Toolauth/wing-reader/breakoutconnect.kicad_sch

## KiCad design breakoutconnect.kicad_sch (2026-04-14)

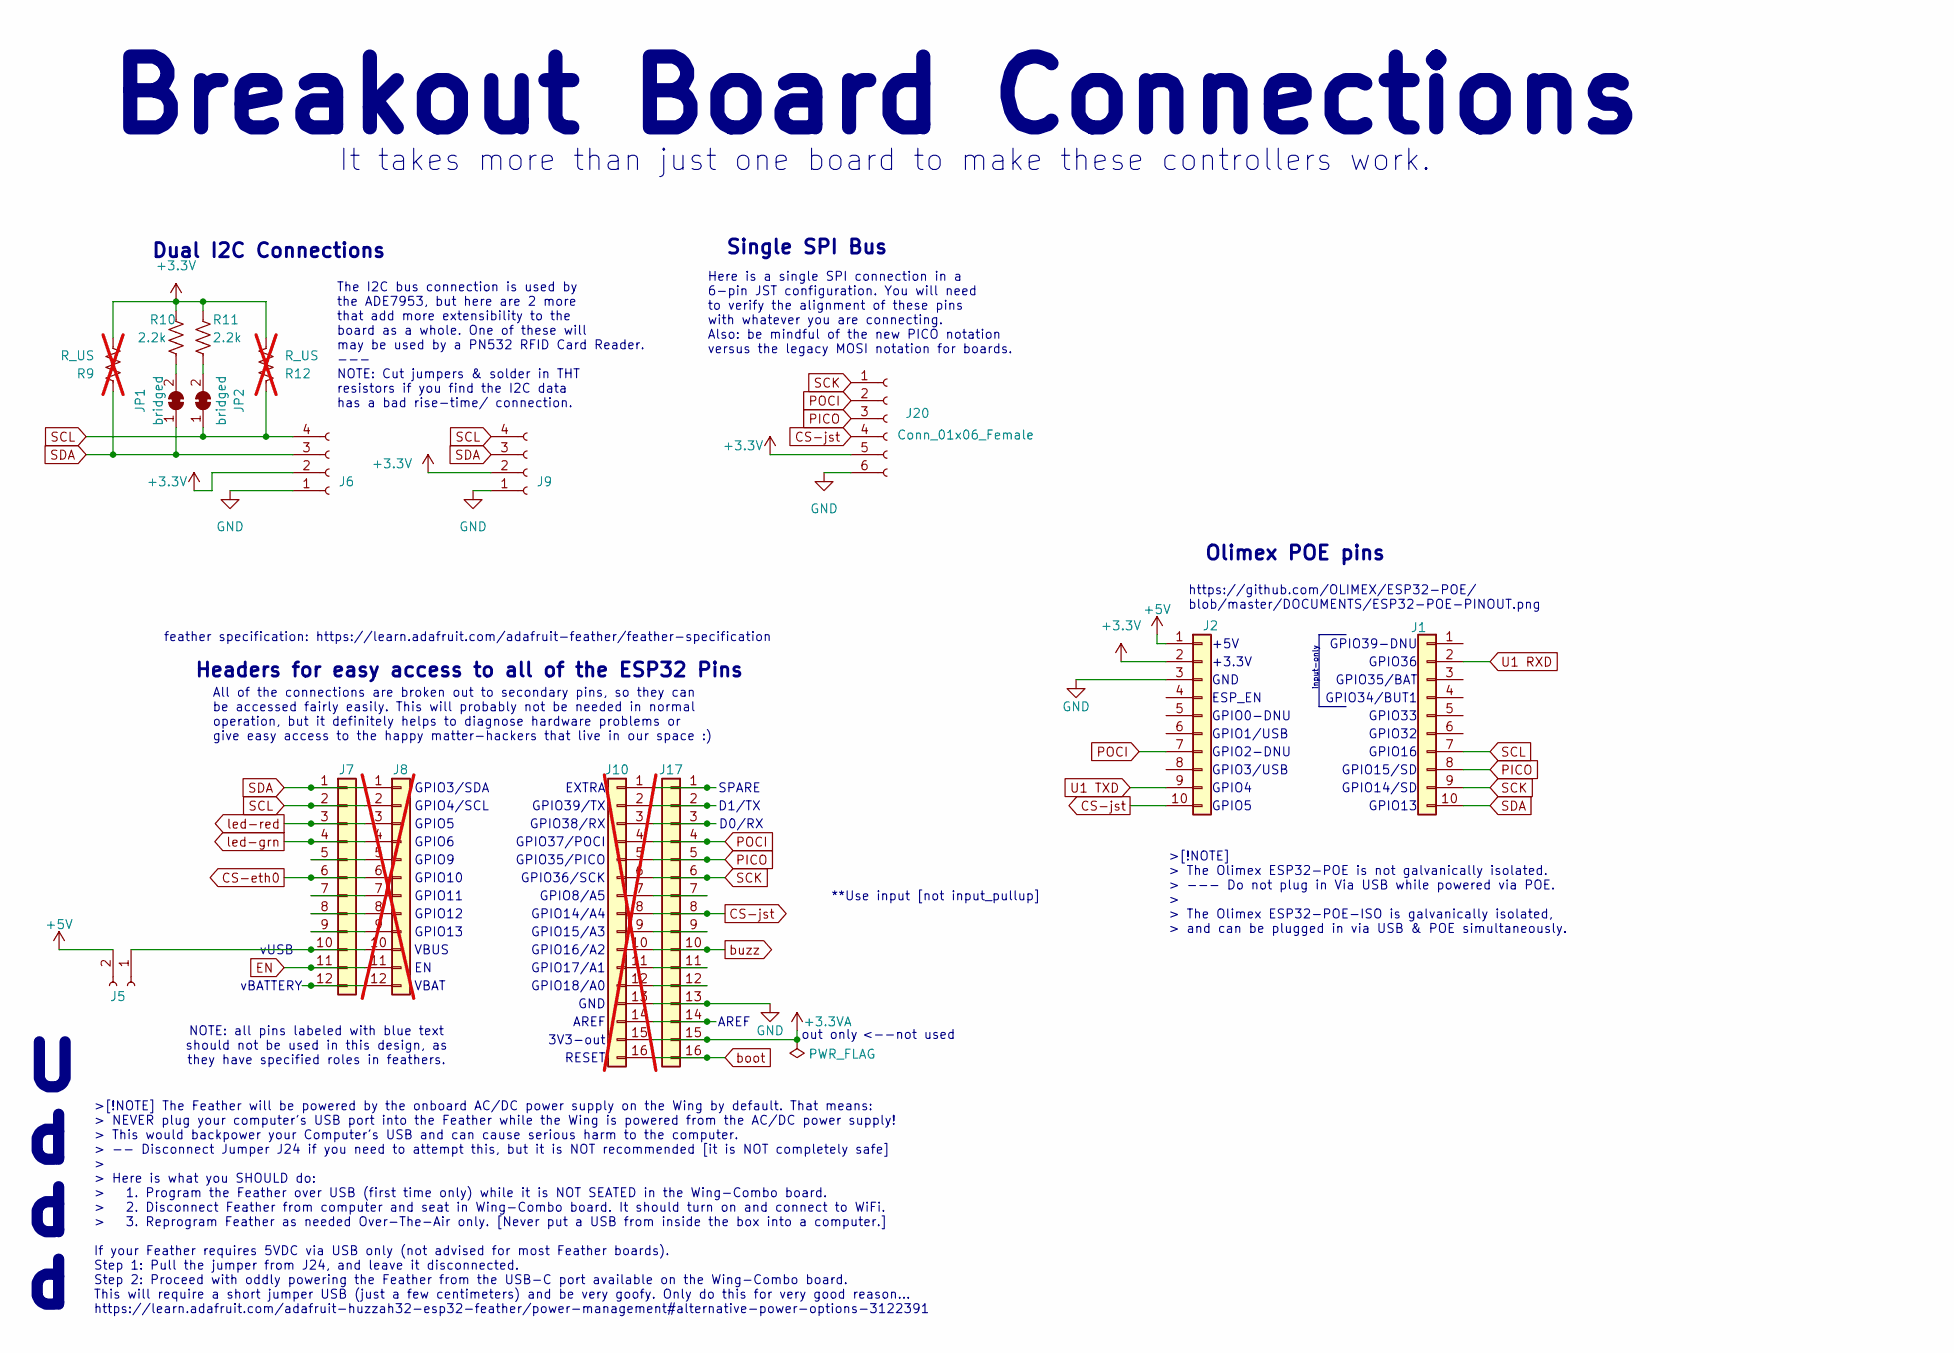
[picture p1: schematic breakoutconnect.kicad_sch]

Parts:
J1, J2: Conn_01x10; PinHeader_1x10_P2.54mm_Vertical; JLCPCB Part # C5116489
J5: powered; PinHeader_1x02_P2.54mm_Vertical
J6, J9: Conn_01x04_Female; JST_PH_B4B-PH-K_1x04_P2.00mm_Vertical; JLCPCB Part # C131334
J7: Conn_01x12; PinSocket_1x12_P2.54mm_Vertical; JLCPCB Part # C2905419
J8: Conn_01x12; PinSocket_1x12_P2.54mm_Vertical; not fitted
J10: Conn_01x16; PinSocket_1x16_P2.54mm_Vertical; not fitted
J17: Conn_01x16; PinSocket_1x16_P2.54mm_Vertical; JLCPCB Part # C2905421
J20: Conn_01x06_Female; JST_PH_B6B-PH-K_1x06_P2.00mm_Vertical; JLCPCB Part # C131342
JP1, JP2: bridged; SolderJumper-2_P1.3mm_Bridged_RoundedPad1.0x1.5mm
R9, R12: R_US; R_Axial_DIN0204_L3.6mm_D1.6mm_P5.08mm_Horizontal; not fitted
R10, R11: 2.2k; R_0603_1608Metric; JLCPCB Part # C4190

Connections:
+3.3V: J2.2, J6.2, J9.2, J20.5, R9.1, R10.2, R11.2, R12.1
+3.3VA: J10.15, J17.15
+5V: J2.1, J5.2
CS-eth0: J7.6, J8.6
CS-jst: J2.10, J10.8, J17.8, J20.4
EN: J7.11, J8.11
GND: J2.3, J6.1, J9.1, J10.13, J17.13, J20.6
unnamed: J5.1, J7.10, J8.10
unnamed: J7.5, J8.5
unnamed: J7.7, J8.7
unnamed: J7.8, J8.8
unnamed: J7.9, J8.9
unnamed: J7.12, J8.12
unnamed: J10.1, J17.1
unnamed: J10.2, J17.2
unnamed: J10.3, J17.3
unnamed: J10.7, J17.7
unnamed: J10.9, J17.9
unnamed: J10.11, J17.11
unnamed: J10.12, J17.12
unnamed: J10.14, J17.14
unnamed: JP1.2 (B), R10.1
unnamed: JP2.2 (B), R11.1
PICO: J1.8, J10.5, J17.5, J20.3
POCI: J2.7, J10.4, J17.4, J20.2
SCK: J1.9, J10.6, J17.6, J20.1
SCL: J1.7, J6.4, J7.2, J8.2, J9.4, JP2.1 (A), R12.2
SDA: J1.10, J6.3, J7.1, J8.1, J9.3, JP1.1 (A), R9.2
U1 RXD: J1.2
U1 TXD: J2.9
boot: J10.16, J17.16
buzz: J10.10, J17.10
led-grn: J7.4, J8.4
led-red: J7.3, J8.3

Notes on the sheet:
GPIO10
GPIO39-DNU
GPIO17/A1
Single SPI Bus
GPIO34/BUT1
GPIO3/USB
U d d d
**Use input [not input_pullup]
GPIO35/BAT
GPIO18/A0
All of the connections are broken out to secondary pins, so they can be accessed fairly easily. This will probably not be needed in normal operation, but it definitely helps to diagnose hardware problems or give easy access to the happy matter-hackers that live in our space :)
ESP_EN
GPIO1/USB
GPIO5
RESET
GPIO8/A5
GPIO32
D0/RX
GPIO15/SD
<--not used
GPIO15/A3
3V3-out
feather specification: https://learn.adafruit.com/adafruit-feather/feather-specification
GPIO13
GPIO3/SDA
+3.3V
out only
GPIO4/SCL
>[!NOTE] > The Olimex ESP32-POE is not galvanically isolated. > --- Do not plug in Via USB while powered via POE. > > The Olimex ESP32-POE-ISO is galvanically isolated, > and can be plugged in via USB & POE simultaneously.
GND
GPIO11
GPIO4
Dual I2C Connections
input-only
GPIO38/RX
GPIO0-DNU
https://github.com/OLIMEX/ESP32-POE/ blob/master/DOCUMENTS/ESP32-POE-PINOUT.png
AREF
vUSB
GPIO36
GPIO33
GPIO14/A4
Olimex POE pins
GPIO16/A2
VBUS
GPIO36/SCK
GPIO12
vBATTERY
Breakout Board Connections
The I2C bus connection is used by the ADE7953, but here are 2 more that add more extensibility to the board as a whole. One of these will may be used by a PN532 RFID Card Reader. --- NOTE: Cut jumpers & solder in THT resistors if you find the I2C data has a bad rise-time/ connection.
D1/TX
GPIO6
GPIO2-DNU
GPIO39/TX
GPIO37/POCI
It takes more than just one board to make these controllers work.
GPIO9
EXTRA
GPIO16
GPIO14/SD
Here is a single SPI connection in a 6-pin JST configuration. You will need to verify the alignment of these pins with whatever you are connecting. Also: be mindful of the new PICO notation versus the legacy MOSI notation for boards.
+5V
>[!NOTE] The Feather will be powered by the onboard AC/DC power supply on the Wing by default. That means: > NEVER plug your computer's USB port into the Feather while the Wing is powered from the AC/DC power supply! > This would backpower your Computer's USB and can cause serious harm to the compu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
GPIO35/PICO
Headers for easy access to all of the ESP32 Pins
VBAT
NOTE: all pins labeled with blue text should not be used in this design, as they have specified roles in feathers.
SPARE
