Toolauth/wing-reader/lightoundstatus.kicad_sch

## KiCad design lightoundstatus.kicad_sch (2026-04-14)

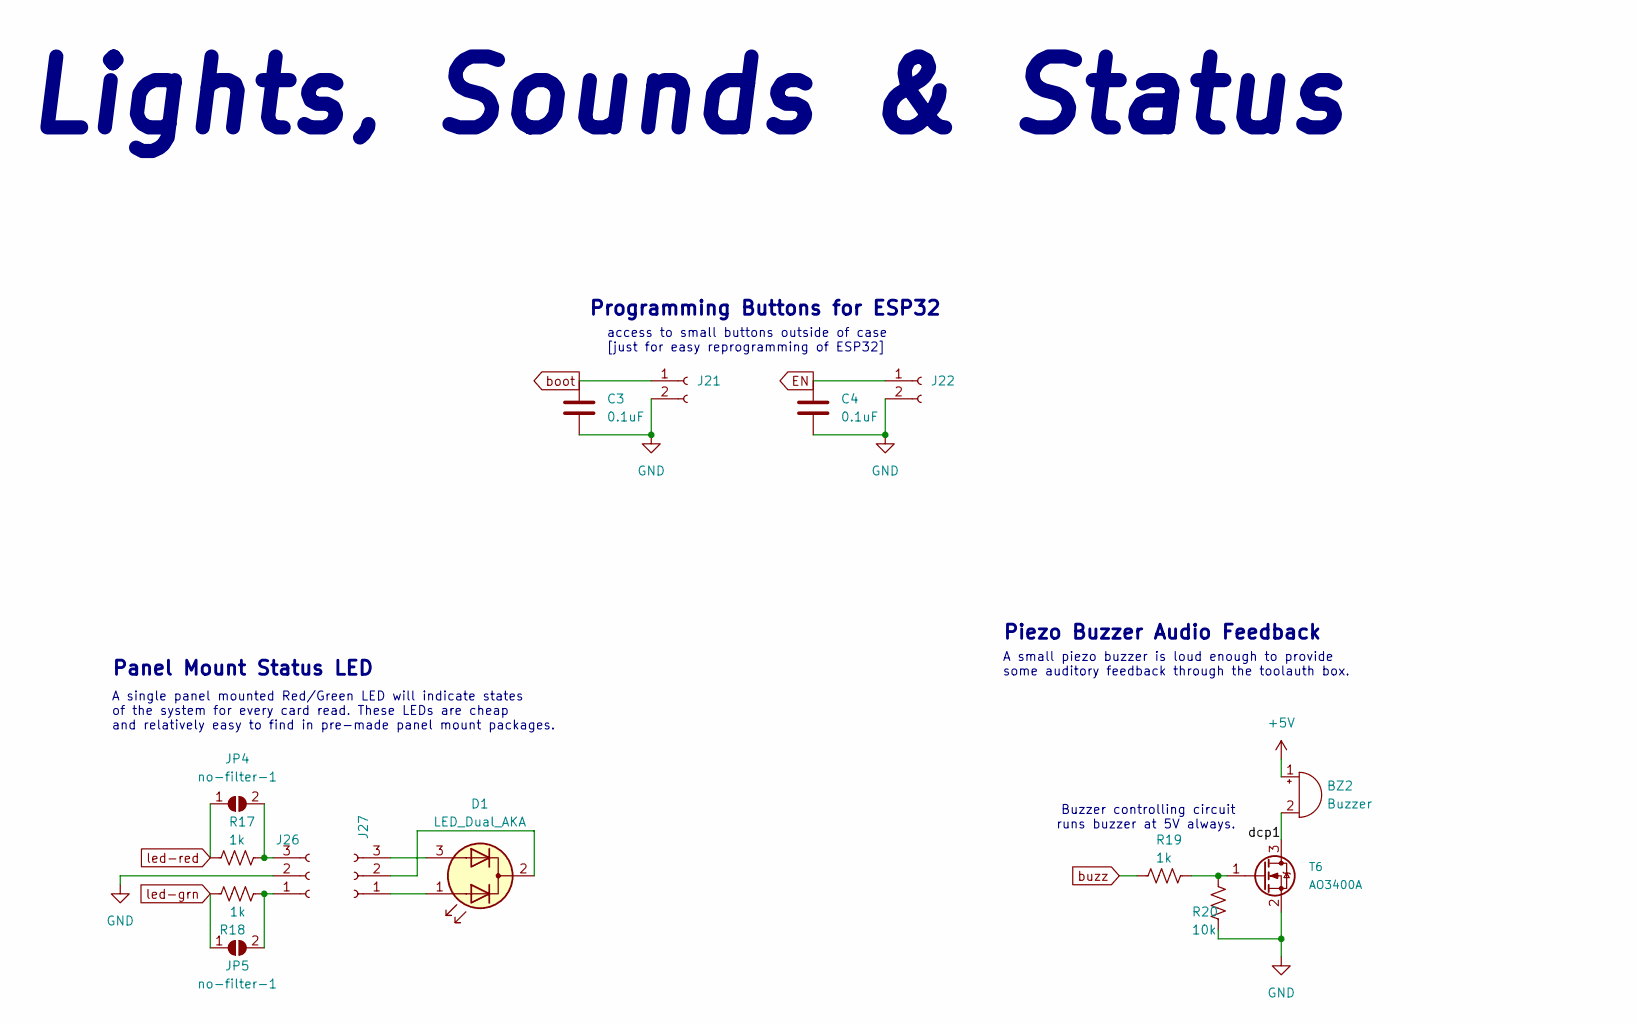
[picture p2: schematic lightoundstatus.kicad_sch]

Parts:
BZ2: Buzzer; BUZ-TH_BD12.0-P7.60-D0.6-FD; JLCPCB Part # C96095
C3, C4: 0.1uF; LED_0603_1608Metric; JLCPCB Part # C14663
D1: LED_Dual_AKA
J21, J22: Conn_01x02_Female; JST_PH_S2B-PH-K_1x02_P2.00mm_Horizontal; JLCPCB Part # C157932
J26: Conn_01x03_Female; JST_PH_B3B-PH-K_1x03_P2.00mm_Vertical; JLCPCB Part # C131339
J27: Conn_01x03_Female
JP4, JP5: no-filter-1; SolderJumper-2_P1.3mm_Open_RoundedPad1.0x1.5mm
R17, R18, R19: 1k; R_0603_1608Metric; JLCPCB Part # C21190
R20: 10k; R_0603_1608Metric; JLCPCB Part # C25804
T6: AO3400A; SOT-23; JLCPCB Part # C427382

Connections:
+5V: BZ2.1 (+)
EN: C4.1, J22.1
GND: C3.2, C4.2, J21.2, J22.2, J26.2, R20.1, T6.2 (S)
unnamed: D1.1 (A1), J27.1
unnamed: D1.2 (K), J27.2
unnamed: D1.3 (A2), J27.3
unnamed: J26.1, JP5.2 (B), R18.1
unnamed: J26.3, JP4.2 (B), R17.2
unnamed: R19.2, R20.2, T6.1 (G)
boot: C3.1, J21.1
buzz: R19.1
dcp1: BZ2.2 (-), T6.3 (D)
led-grn: JP5.1 (A), R18.2
led-red: JP4.1 (A), R17.1

Notes on the sheet:
Programming Buttons for ESP32
A single panel mounted Red/Green LED will indicate states of the system for every card read. These LEDs are cheap and relatively easy to find in pre-made panel mount packages.
A small piezo buzzer is loud enough to provide some auditory feedback through the toolauth box.
access to small buttons outside of case [just for easy reprogramming of ESP32]
Buzzer controlling circuit runs buzzer at 5V always.
Piezo Buzzer Audio Feedback
Panel Mount Status LED
Lights, Sounds & Status
