Toolauth/wing-reader/(commit log)

2026-04-14 almost ready to start
    [CFM06S050-E.stp, F1812.step, PY14_02.step, RES-ARRAY-SMD_0402-8P-L2.0-W1.0-BL.step, RES-ARRAY-SMD_0603-8P-L3.2-W1.6-BL.step, SOIC-14_L8.7-W3.9-P1.27-LS6.0-BL.step, SOIC-8_L5.0-W4.0-P1.27-LS6.0-BL.step, Toolauth_Wing-Combo_1.4.4_bom.csv]
2026-04-14 remove legacy
    [ade7953.kicad_sch, breakoutboards.kicad_sch, esp32core.kicad_sch, microcontroller.kicad_sch]
2026-04-14 adjust for wing-reader
